stheophil/MappingRover/3D/gyroholder_complete4.stl

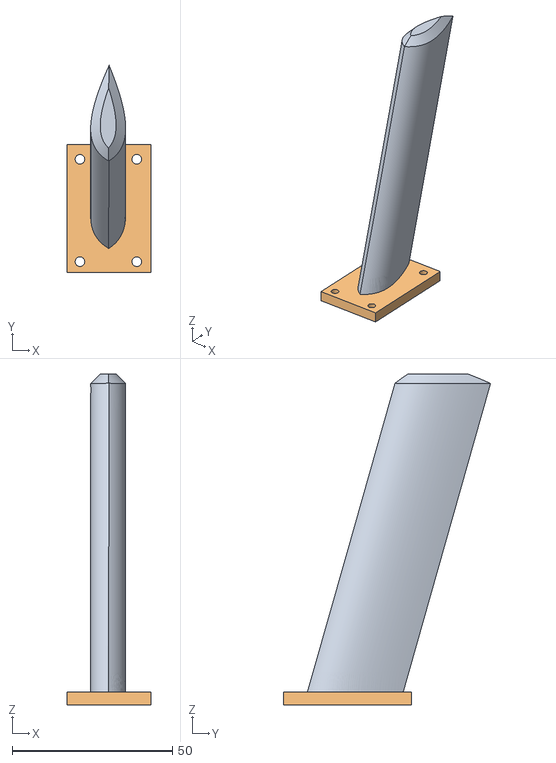
[picture p2: CAD file, 2015-10-04]
3D/gyroholder_complete4.stl
26.4 x 64.7 x 103.4
