stheophil/MappingRover/motormeasurement.xlsx

Sheet: Forward
PWM = 255 | Encoder ticks |  |  |  | Speed
t [ms] | M0 | M1 | M2 | M3 | M0 | M1 | M2 | M3
50 | 14 | 13 | 14 | 11
100 | 37 | 37 | 39 | 32 | 23 | 24 | 25 | 21
150 | 63 | 64 | 66 | 57 | 26 | 27 | 27 | 25
200 | 90 | 93 | 94 | 84 | 27 | 29 | 28 | 27
250 | 118 | 122 | 123 | 112 | 28 | 29 | 29 | 28
300 | 145 | 150 | 152 | 140 | 27 | 28 | 29 | 28
350 | 174 | 180 | 181 | 169 | 29 | 30 | 29 | 29
400 | 202 | 209 | 211 | 197 | 28 | 29 | 30 | 28
450 | 231 | 238 | 240 | 226 | 29 | 29 | 29 | 29
500 | 260 | 268 | 270 | 254 | 29 | 30 | 30 | 28
550 | 289 | 297 | 299 | 283 | 29 | 29 | 29 | 29
600 | 317 | 327 | 329 | 311 | 28 | 30 | 30 | 28
650 | 346 | 357 | 359 | 340 | 29 | 30 | 30 | 29
700 | 375 | 387 | 388 | 368 | 29 | 30 | 29 | 28
750 | 404 | 417 | 418 | 398 | 29 | 30 | 30 | 30
800 | 433 | 447 | 447 | 427 | 29 | 30 | 29 | 29
850 | 462 | 477 | 477 | 456 | 29 | 30 | 30 | 29
900 | 491 | 506 | 507 | 485 | 29 | 29 | 30 | 29
950 | 520 | 535 | 536 | 513 | 29 | 29 | 29 | 28
1000 | 548 | 565 | 566 | 541 | 28 | 30 | 30 | 28
 | 500 | Encoder ticks per second at 255 PWM
 | 1.501501502 | rotations / s
 | 56.60527304 | cm / s | mit 12 cm Rädern
 | 14 | 13 | 14 | 11
 | 37 | 37 | 39 | 32
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
