stheophil/MappingRover/rover/src/calibrate.h

LSM303::vector<int16_t> running_min = {32767, 32767, 32767}, running_max = {-32768, -32768, -32768};

char report[80];
static bool bFirstRun = true;

void loop() {
    if(bFirstRun) {
        OnConnection(); // calibrate with running motors to test with interference
        for(int i=0; i<countof(g_amotors); ++i) {
            analogWrite(g_amotors[i].POWER, 128);
        }
        bFirstRun = false;
    } else {
        compass.read();
        
        running_min.x = min(running_min.x, compass.m.x);
        running_min.y = min(running_min.y, compass.m.y);
        running_min.z = min(running_min.z, compass.m.z);
        
        running_max.x = max(running_max.x, compass.m.x);
        running_max.y = max(running_max.y, compass.m.y);
        running_max.z = max(running_max.z, compass.m.z);
        
        snprintf(report, sizeof(report), "min: {%+6d, %+6d, %+6d}    max: {%+6d, %+6d, %+6d}",
                 running_min.x, running_min.y, running_min.z,
                 running_max.x, running_max.y, running_max.z);
        Serial.println(report);
        
        delay(100);
    }
}
