stheophil/MappingRover/(commit log)

2014-12-02 Send motor commands via Bluetooth
2014-12-02 Move arduino file
2014-12-15 Bluetooth remote works now
    [motormeasurement.xlsx]
2014-12-26 Migrate arduino project to pure C++ with http://inotool.org
2014-12-28 Transfer encoder ticks & rotation angles
2015-01-07 Send sonar data back. More encoder measurements.
    [motormeasurement.xlsx]
2015-01-11 Add PID with a measurement loop() and PID results in Excel file.
    [pidtest.xlsx]
2015-01-11 Control robot with PID enabled
2015-01-21 Add three sonar sensors
2015-02-13 Calibrate with motor running and gyro mounted at distance
2015-02-22 Cleanup drawing, improve sensor model
2015-09-28 Add OpenCV image erosion. Add timer again.
2015-10-01 Find move vector that maximizes path length close to obstacles (so they are scanned from a short distance)
    [edge_following_strategy.cpp, edge_following_strategy.h, geometry.h, robot_controller.cpp]
2015-10-04 Added models of axis adaptor & holder for the IMU
    [axis_adaptor.scad, gyroholder_complete4.stl]
