stheophil/MappingRover/(notices)

Notices in the files:
rover/src/ahrs.cpp:
under the terms of the GNU Lesser General Public License as published by the
Free Software Foundation, either version 3 of the License, or (at your option)
